StarCraftFANS/asp/README.md

asp
===

Atmel Serial Programmer for 8051 microcontroller
