StarCraftFANS/asp/kicad/asp_pic_at89s52_test/asp_pic_at89s52_test.pdf

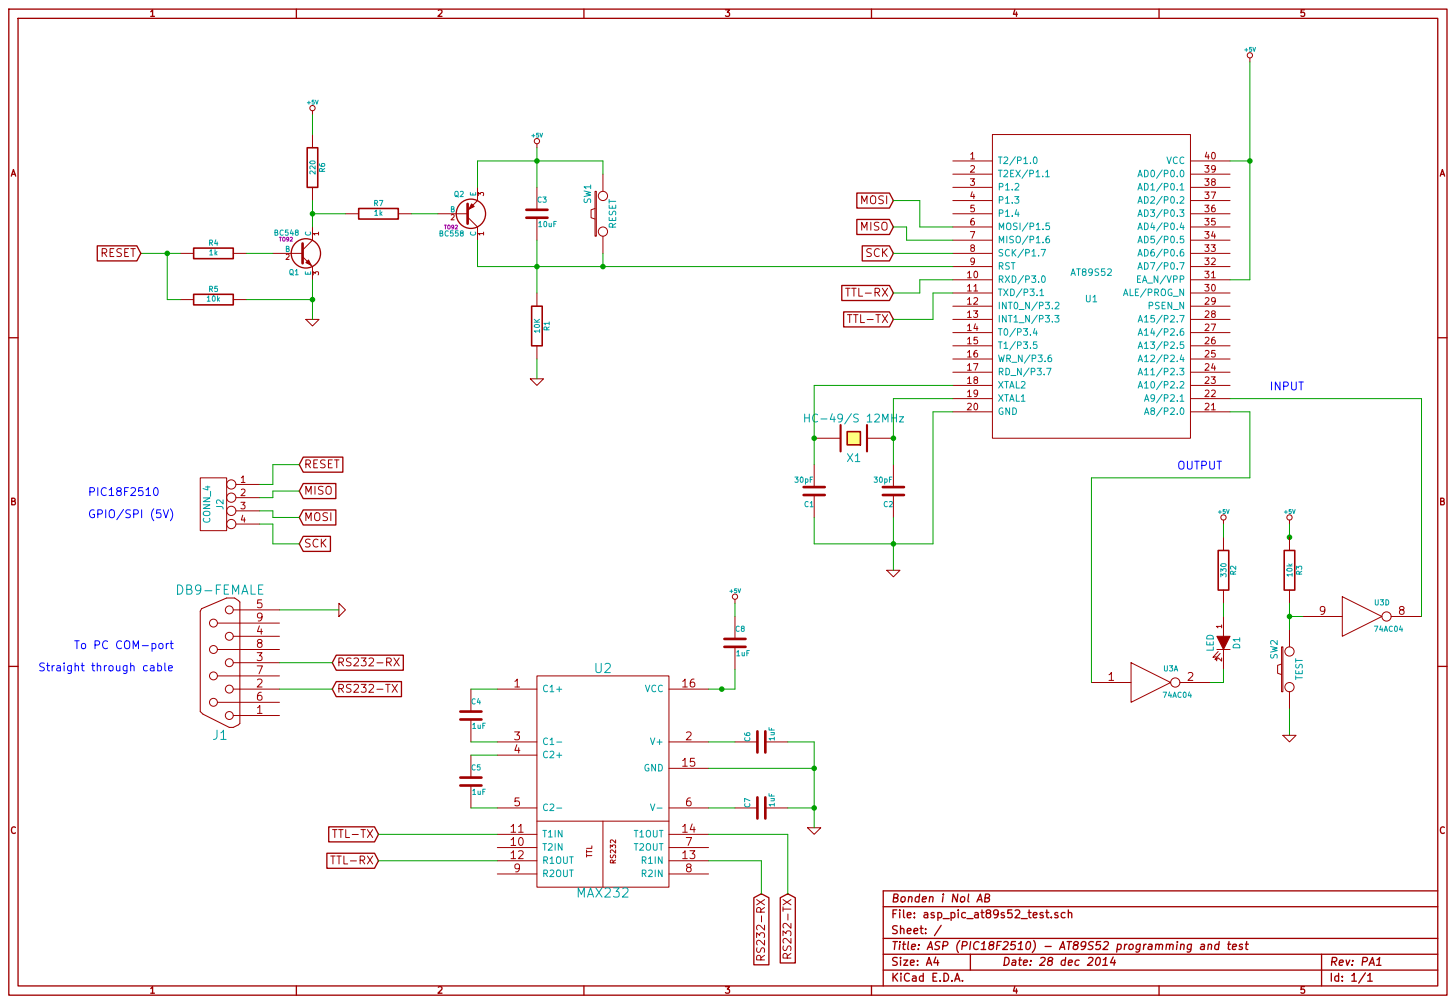
[picture p1: page 1]

To PC COM-port
Straight through cable

Sheet: / Bonden i Nol AB
File: asp_pic_at89s52_test.sch

Title: ASP (PIC18F2510) - AT89S52 programming and test
