StarCraftFANS/asp/kicad/asp_rpi_at89s52_test/asp_rpi_at89s52_test.pdf

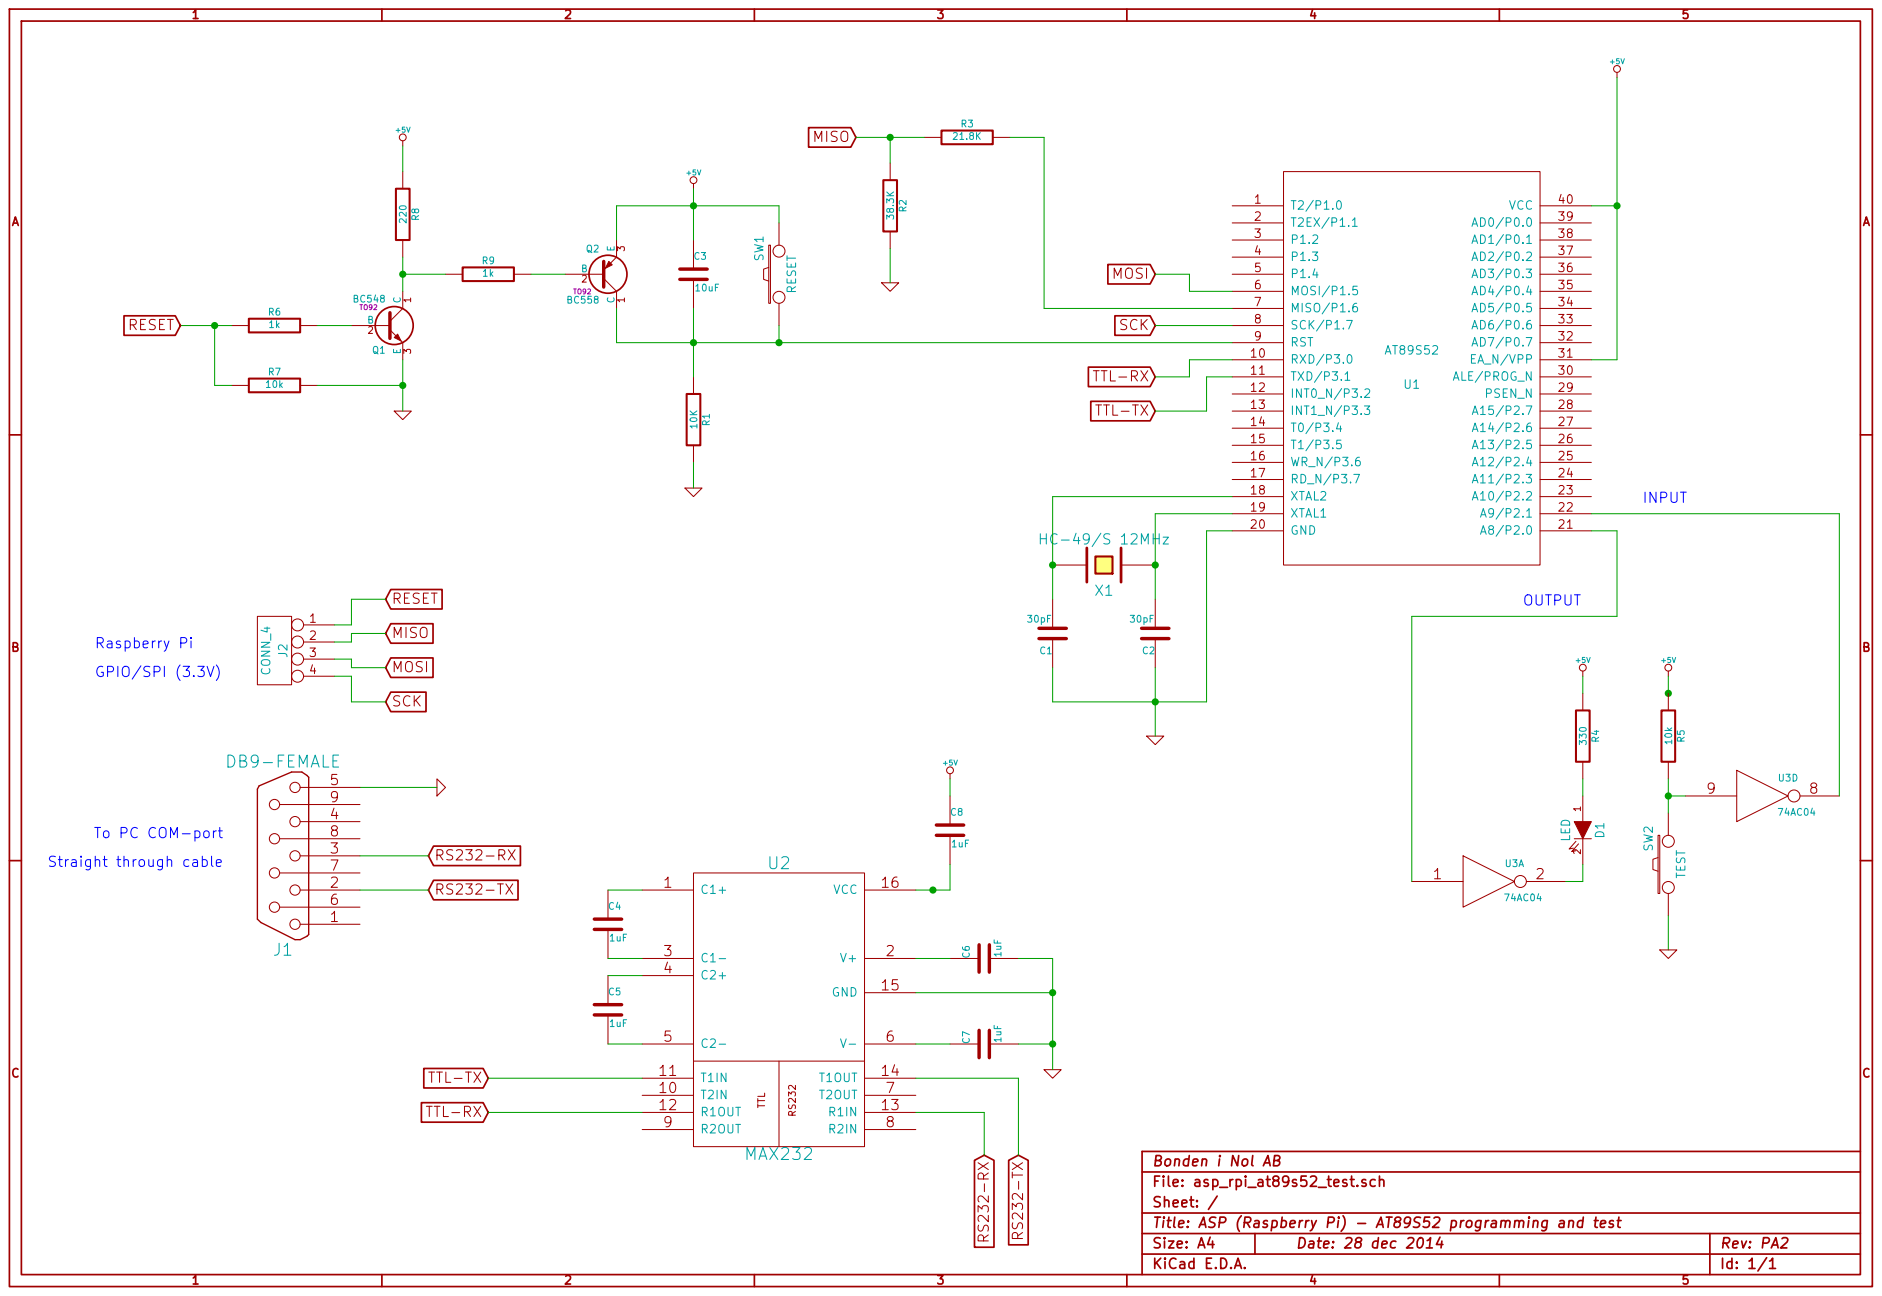
[picture p2: page 1]

To PC COM-port
Straight through cable

Sheet: / Bonden i Nol AB
File: asp_rpi_at89s52_test.sch

Title: ASP (Raspberry Pi) - AT89S52 programming and test
