StarCraftFANS/asp/kicad/asp_pic/asp_pic_pic18f2510.pdf

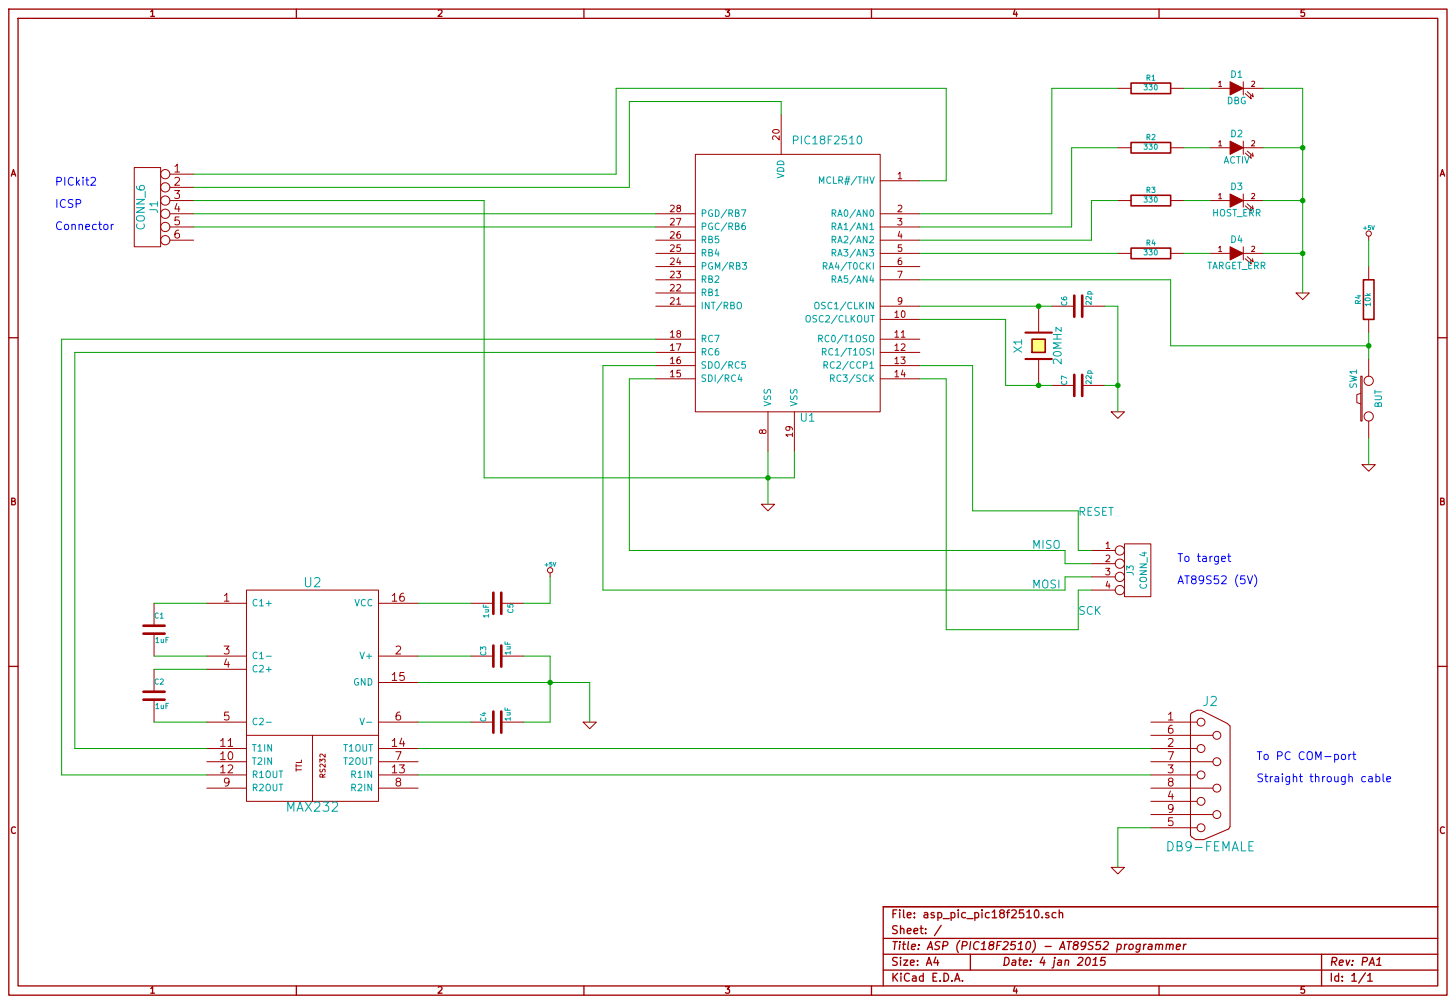
[picture p3: page 1]

Straight through cable RS232 TTL C1+ 1

To PC COM-port
