StarCraftFANS/asp/ltspice/asp_rpi_reset_at89s52.asc

C1: cap; 10µ
Q1: npn
Q2: pnp
R1: res; 1k
R2: res; 220
R3: res; 1k
R4: res; 10k
R5: res; 10k
V1: voltage; PULSE(0 3.3 0.1 0 0 0.4 1 1)
V2: voltage; 5
Named nets: 0, VRESET, VCC, VIN
.tran 1000m startup
