StarCraftFANS/asp/kicad/asp_pic/asp_pic_pic18f2510.sch

## KiCad design kicad/asp_pic/asp_pic_pic18f2510.sch (2015-01-04)

Schematic: asp_pic_pic18f2510.sch

Parts:
C1, C2, C3, C4, C5: 1uF
C6, C7: 22p
D1: DBG
D2: ACTIV
D3: HOST_ERR
D4: TARGET_ERR
J1: CONN_6
J2: DB9-FEMALE
J3: CONN_4
R1, R2, R3, R4: 330
SW1: BUT
U1: PIC18F2510
U2: MAX232
X1: 20MHz

Notes on the sheet:
PICkit2 ICSP Connector
To target AT89S52 (5V)
To PC COM-port Straight through cable
