StarCraftFANS/asp/kicad/asp_rpi_at89s52_test/asp_rpi_at89s52_test.sch

## KiCad design kicad/asp_rpi_at89s52_test/asp_rpi_at89s52_test.sch (2015-01-04)

Schematic: asp_rpi_at89s52_test.sch

Parts:
C1, C2: 30pF
C3: 10uF
C4, C5, C6, C7, C8: 1uF
D1: LED
J1: DB9-FEMALE
J2: CONN_4
Q1: BC548; TO92
Q2: BC558; TO92
R1: 10K
R2: 38.3K
R3: 21.8K
R4: 330
R5, R7: 10k
R6, R9: 1k
R8: 220
SW1: RESET
SW2: TEST
U1: AT89S52; MODULE
U2: MAX232
U3: 74AC04
X1: HC-49/S 12MHz

Notes on the sheet:
Raspberry Pi GPIO/SPI (3.3V)
To PC COM-port Straight through cable
INPUT
OUTPUT
