StarCraftFANS/asp/pic/src/main.c

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
#include "platform.h"

#include "config_bits.h"
#include "asp_hw.h"
#include "asp_ui.h"

/////////////////////////////////////////////////////////////////////////////
//               Definition of macros
/////////////////////////////////////////////////////////////////////////////

/////////////////////////////////////////////////////////////////////////////
//               Definition of types
/////////////////////////////////////////////////////////////////////////////

/////////////////////////////////////////////////////////////////////////////
//               Function prototypes
/////////////////////////////////////////////////////////////////////////////

/////////////////////////////////////////////////////////////////////////////
//               Global variables
/////////////////////////////////////////////////////////////////////////////

////////////////////////////////////////////////////////////////

void main(void)
{
  asp_hw_initialize();  // Initalize hardware
  asp_ui_execute();     // Execute ASP
}
