StarCraftFANS/asp/pic/src/asp.c

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
#include "asp.h"
#include "at89s52_isp.h"

/////////////////////////////////////////////////////////////////////////////
//               Definitions of macros
/////////////////////////////////////////////////////////////////////////////

/////////////////////////////////////////////////////////////////////////////
//               Support types
/////////////////////////////////////////////////////////////////////////////

/////////////////////////////////////////////////////////////////////////////
//               Function prototypes
/////////////////////////////////////////////////////////////////////////////

/////////////////////////////////////////////////////////////////////////////
//               Global variables
/////////////////////////////////////////////////////////////////////////////

/////////////////////////////////////////////////////////////////////////////
//               Public functions
/////////////////////////////////////////////////////////////////////////////

////////////////////////////////////////////////////////////////

int asp_chip_probe(void)
{
  if (at89s52_isp_probe() != AT89S52_ISP_SUCCESS) {
    return ASP_FAILURE;
  }
  return ASP_SUCCESS;
}

////////////////////////////////////////////////////////////////

int asp_chip_erase(void)
{
  if (at89s52_isp_erase() != AT89S52_ISP_SUCCESS) {
    return ASP_FAILURE;
  }
  return ASP_SUCCESS;
}

////////////////////////////////////////////////////////////////

int asp_chip_read_bin(void)
{
  if (at89s52_isp_read_bin() != AT89S52_ISP_SUCCESS) {
    return ASP_FAILURE;
  }
  return ASP_SUCCESS;
}

////////////////////////////////////////////////////////////////

int asp_chip_write_bin(void)
{
  if (at89s52_isp_write_bin() != AT89S52_ISP_SUCCESS) {
    return ASP_FAILURE;
  }
  return ASP_SUCCESS;
}

////////////////////////////////////////////////////////////////

int asp_chip_verify_bin(void)
{
  if (at89s52_isp_verify_bin() != AT89S52_ISP_SUCCESS) {
    return ASP_FAILURE;
  }
  return ASP_SUCCESS;
}

////////////////////////////////////////////////////////////////

int asp_chip_read_hex(void)
{
  if (at89s52_isp_read_hex() != AT89S52_ISP_SUCCESS) {
    return ASP_FAILURE;
  }
  return ASP_SUCCESS;
}

////////////////////////////////////////////////////////////////

int asp_chip_write_hex(void)
{
  if (at89s52_isp_write_hex() != AT89S52_ISP_SUCCESS) {
    return ASP_FAILURE;
  }
  return ASP_SUCCESS;
}

////////////////////////////////////////////////////////////////

int asp_chip_verify_hex(void)
{
  if (at89s52_isp_verify_hex() != AT89S52_ISP_SUCCESS) {
    return ASP_FAILURE;
  }
  return ASP_SUCCESS;
}

/////////////////////////////////////////////////////////////////////////////
//               Private functions
/////////////////////////////////////////////////////////////////////////////

////////////////////////////////////////////////////////////////
