StarCraftFANS/asp/pic/src/ihex.h

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
#ifndef __IHEX_H__
#define __IHEX_H__

#include <stdint.h>

#include "ihex_record.h"
#include "ihex_private.h"

/////////////////////////////////////////////////////////////////////////////
//               Definition of macros
/////////////////////////////////////////////////////////////////////////////
// Return codes
#define IHEX_SUCCESS        0
#define IHEX_RECORD_READY  -1
#define IHEX_FORMAT_ERROR  -2
#define IHEX_BAD_REC_TYPE  -3
#define IHEX_CHKSUM_ERROR  -4

/////////////////////////////////////////////////////////////////////////////
//               Definition of types
/////////////////////////////////////////////////////////////////////////////
// The opaque pointer type
typedef IHEX *IHEX_HANDLE;

/////////////////////////////////////////////////////////////////////////////
//               Definition of exported functions
/////////////////////////////////////////////////////////////////////////////
int ihex_get_file_size(uint8_t record_data_bytes,
		       uint16_t records,
		       uint32_t *nbytes);

int ihex_initialize(IHEX_HANDLE handle);

int ihex_ascii_to_bin_record(IHEX_HANDLE handle,
			     uint8_t data);

int ihex_get_bin_record(IHEX_HANDLE handle,
			IHEX_RECORD **rec);

int ihex_bin_to_ascii_record(IHEX_HANDLE handle,
			     uint16_t addr,
			     uint8_t type,
			     const uint8_t *data,
			     uint8_t nbytes);

int ihex_get_ascii_record(IHEX_HANDLE handle,
			  uint8_t requested_bytes,
			  uint8_t *actual_bytes,
			  uint8_t **data);

#endif // __IHEX_H__
