StarCraftFANS/asp/pic/src/asp_ui.c

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
#include <stdint.h>

#include "asp_ui.h"
#include "asp_prod_info.h"
#include "asp_hw.h"
#include "asp.h"
#include "user_io.h"

/////////////////////////////////////////////////////////////////////////////
//               Definitions of macros
/////////////////////////////////////////////////////////////////////////////

/////////////////////////////////////////////////////////////////////////////
//               Definitions of types
/////////////////////////////////////////////////////////////////////////////
// Commands
typedef enum {
  UI_CMD_PROBE,
  UI_CMD_ERASE,
  UI_CMD_READ_BIN,
  UI_CMD_WRITE_BIN,
  UI_CMD_VERIFY_BIN,
  UI_CMD_READ_HEX,
  UI_CMD_WRITE_HEX,
  UI_CMD_VERIFY_HEX,
  UI_CMD_UNKNOWN  // Must be last enum
} UI_CMD;

// Function pointer associated with a command
typedef int (*UI_CMD_FUNC)(void);

/////////////////////////////////////////////////////////////////////////////
//               Function prototypes
/////////////////////////////////////////////////////////////////////////////
static void print_menu(void);
static void clear_errors(void);

/////////////////////////////////////////////////////////////////////////////
//               Global variables
/////////////////////////////////////////////////////////////////////////////
static UI_CMD_FUNC g_ui_cmd_func[UI_CMD_UNKNOWN] =
{
  asp_chip_probe,          // UI_CMD_PROBE
  asp_chip_erase,          // UI_CMD_ERASE
  asp_chip_read_bin,       // UI_CMD_READ_BIN
  asp_chip_write_bin,      // UI_CMD_WRITE_BIN
  asp_chip_verify_bin,     // UI_CMD_VERIFY_BIN
  asp_chip_read_hex,       // UI_CMD_READ_HEX
  asp_chip_write_hex,      // UI_CMD_VERIFY_HEX
  asp_chip_verify_hex      // UI_CMD_VERIFY_HEX
};

/////////////////////////////////////////////////////////////////////////////
//               Public functions
/////////////////////////////////////////////////////////////////////////////

////////////////////////////////////////////////////////////////

void asp_ui_execute(void)
{
  int rc;
  uint8_t value;
  UI_CMD ui_cmd;

  do {
    print_menu();   
    user_io_put(ASP_PROD_INFO">", ASP_PROD_INFO_LEN+1);

    // Wait for command
    do {
      while (user_io_get(&value) != USER_IO_SUCCESS) { ; }
      switch(value) {
      case 0x31: // '1'
	ui_cmd = UI_CMD_PROBE;
	break;
      case 0x32: // '2'
	ui_cmd = UI_CMD_ERASE;
	break;
      case 0x33: // '3'
	ui_cmd = UI_CMD_READ_BIN;
	break;
      case 0x34: // '4'
	ui_cmd = UI_CMD_WRITE_BIN;
	break;
      case 0x35: // '5'
	ui_cmd = UI_CMD_VERIFY_BIN;
	break;
      case 0x36: // '6'
	ui_cmd = UI_CMD_READ_HEX;
	break;
      case 0x37: // '7'
	ui_cmd = UI_CMD_WRITE_HEX;
	break;
      case 0x38: // '8'
	ui_cmd = UI_CMD_VERIFY_HEX;
	break;
      default:
	ui_cmd = UI_CMD_UNKNOWN;
      }
    } while (ui_cmd == UI_CMD_UNKNOWN);

    clear_errors(); // Clear any previous errors
    
    // Excecute command
    rc = g_ui_cmd_func[ui_cmd]();
    if (rc != ASP_SUCCESS) {
      user_io_new_line();
      user_io_put("***ERROR", 8);
    }
  } while (1);
}

/////////////////////////////////////////////////////////////////////////////
//               Private functions
/////////////////////////////////////////////////////////////////////////////

////////////////////////////////////////////////////////////////

static void print_menu(void)
{
  user_io_new_line();
  user_io_new_line();
  user_io_put_line("----------------", 16);
  user_io_put_line("--  ASP MENU  --", 16);
  user_io_put_line("----------------", 16);
  user_io_put_line("  1. probe",       10);
  user_io_put_line("  2. erase",       10);
  user_io_put_line("  3. read bin",    13);
  user_io_put_line("  4. write bin",   14);
  user_io_put_line("  5. verify bin",  15);
  user_io_put_line("  6. read hex",    13);
  user_io_put_line("  7. write hex",   14);
  user_io_put_line("  8. verify hex",  15);
  user_io_new_line();
}

////////////////////////////////////////////////////////////////

static void clear_errors(void)
{
  // Clear any indicated errors
  HOST_ERR_LED_OFF;
  TARGET_ERR_LED_OFF;
}
