StarCraftFANS/asp/(notices)

Notices in the files:
picsim/src/asp.c:
Copyright (C) 2014 Bonden i Nol (hakanbrolin@hotmail.com)
This program is free software; you can redistribute it and/or modify
it under the terms of the GNU General Public License as published by
the Free Software Foundation; either version 2 of the License, or
(at your option) any later version.
pic/src/sdcc_defs.h:
Copyright (C) 2015 Bonden i Nol (hakanbrolin@hotmail.com)
